antmicro/programmable-led-panel/doc/led-panel-schematic.pdf

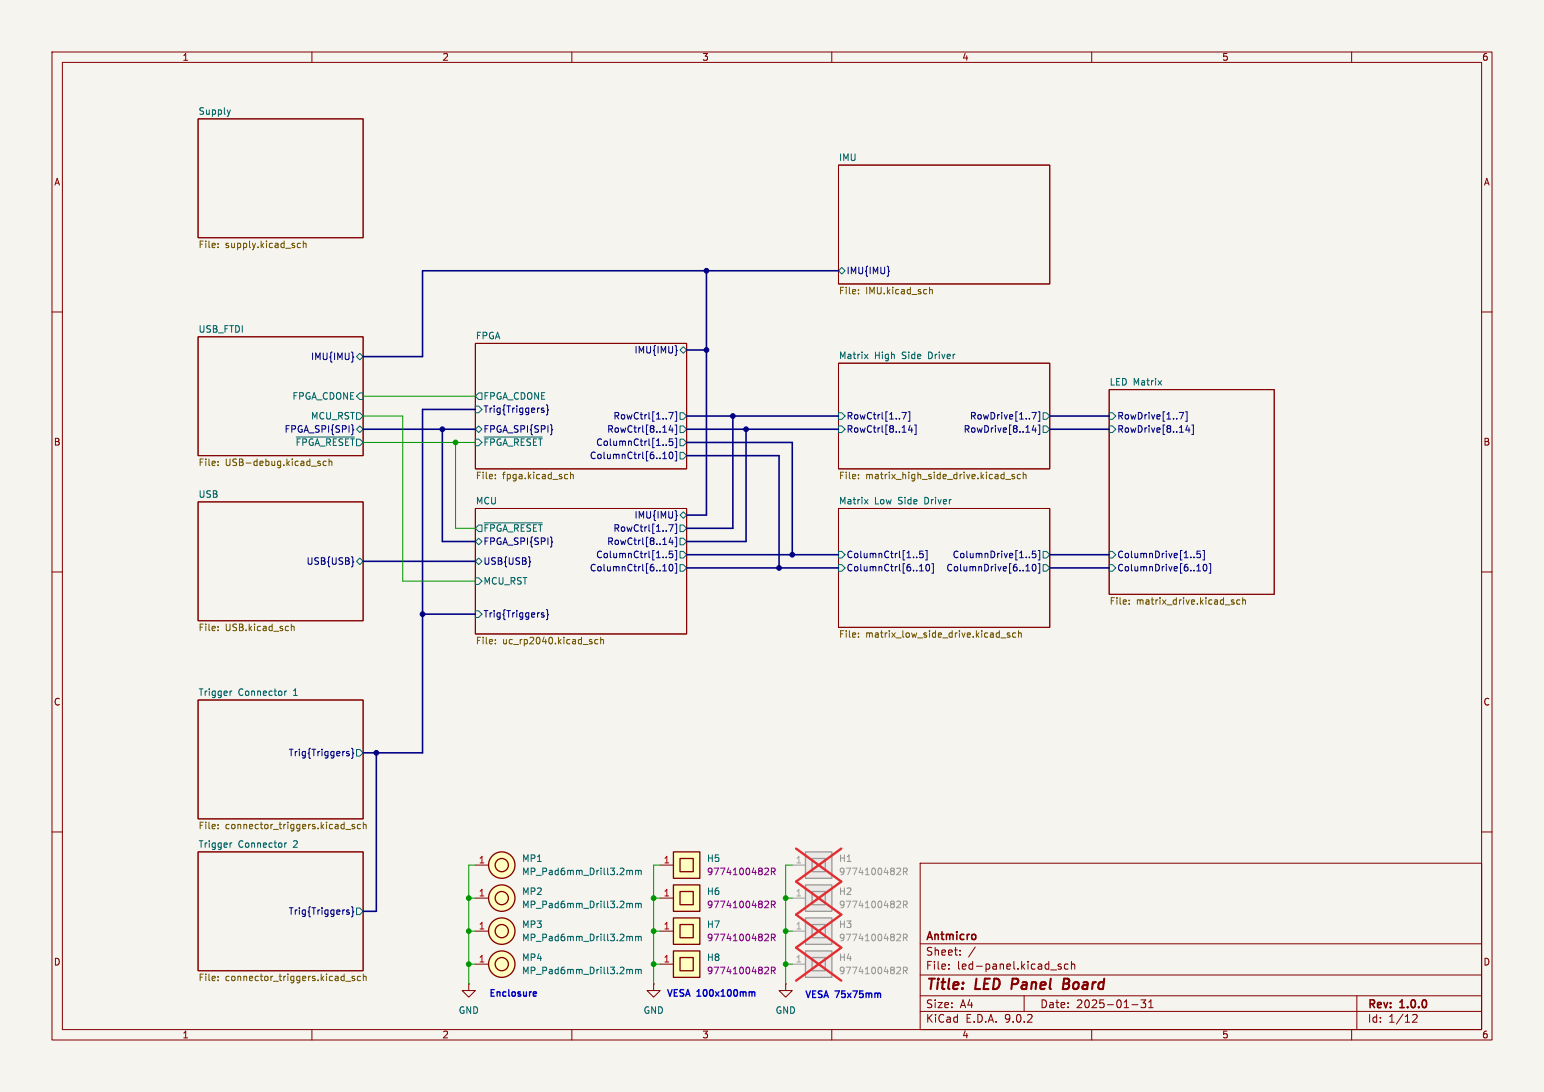
[picture p1: page 1]

RowCtrl[1..7] Matrix High Side Driver File: matrix_high_side_drive.kicad_sch

File: led-panel.kicad_sch Sheet: / Antmicro USB{USB} USB

Id: 1/12 Title: LED Panel Board

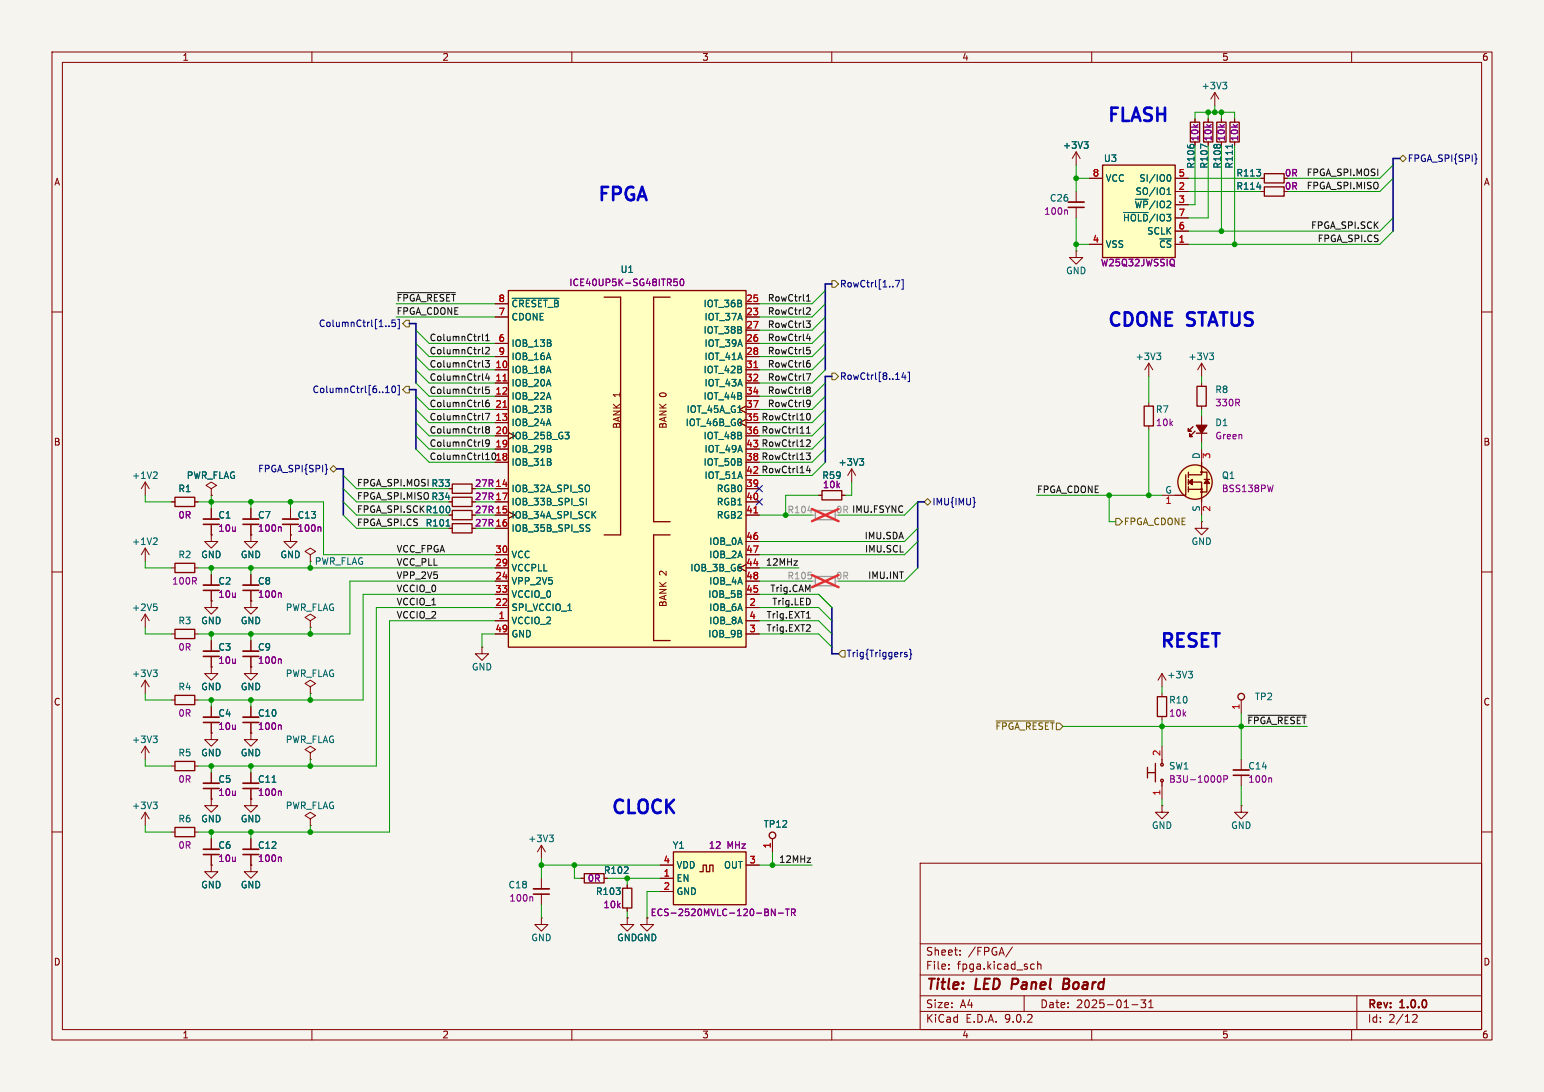
[picture p2: page 2]

File: fpga.kicad_sch Sheet: /FPGA/
Id: 2/12 Title: LED Panel Board

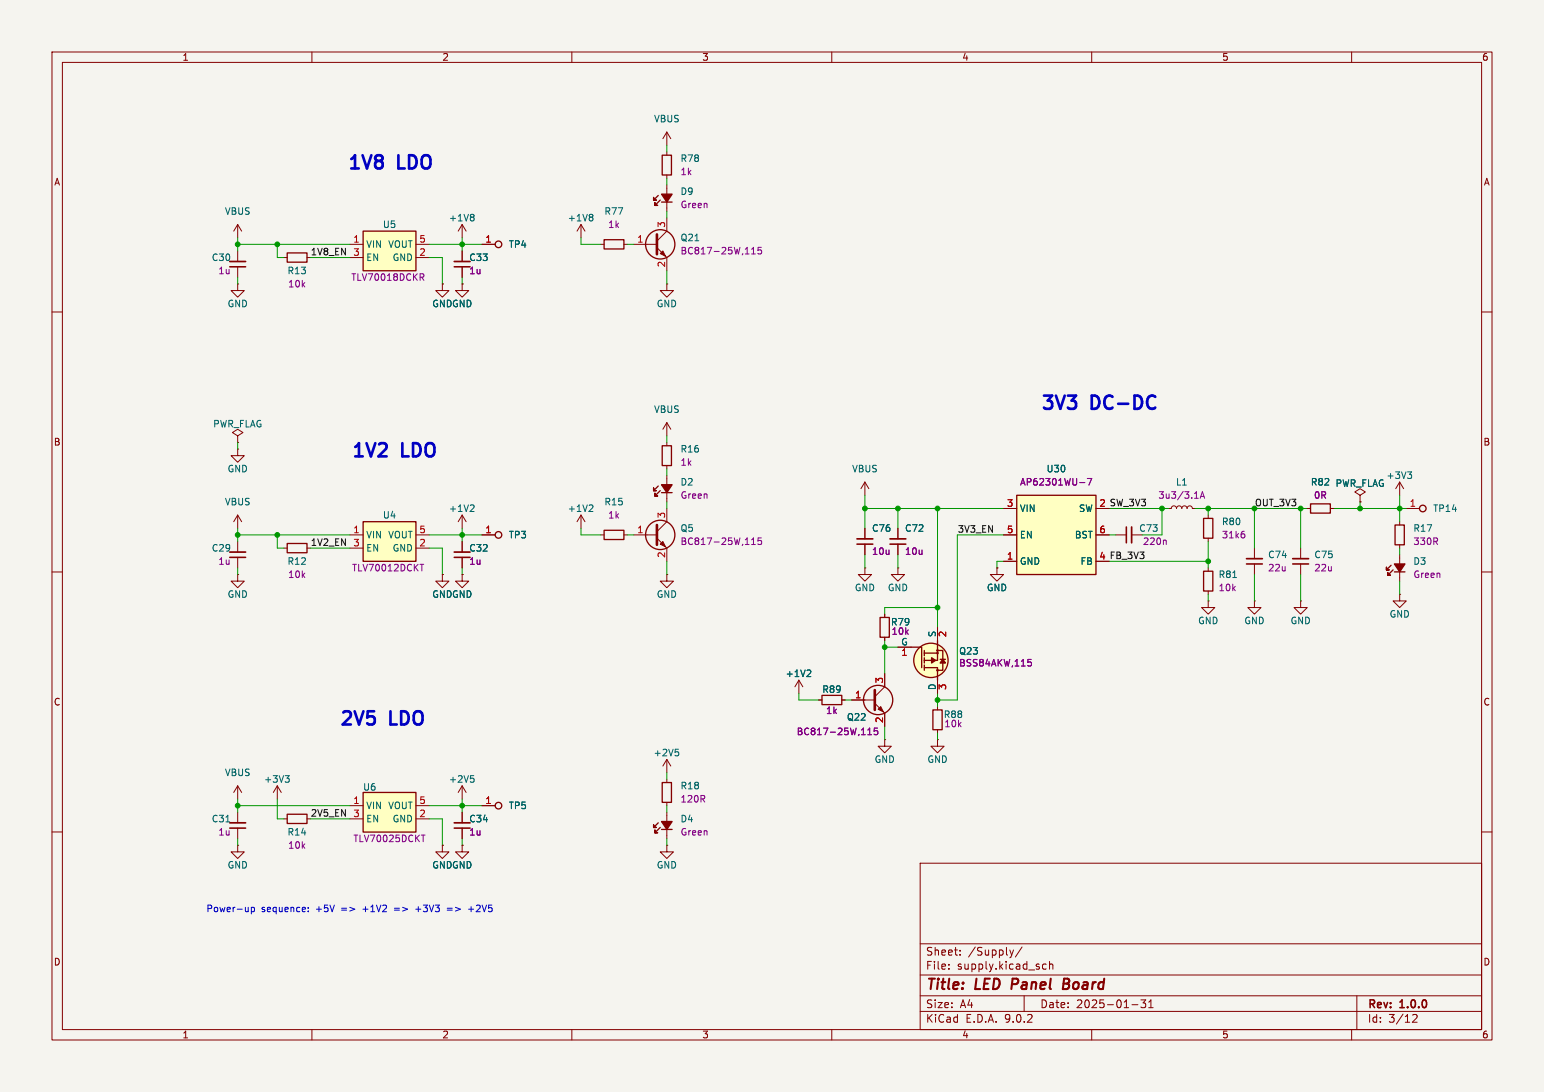
[picture p3: page 3]

File: supply.kicad_sch Sheet: /Supply/
Id: 3/12 Title: LED Panel Board

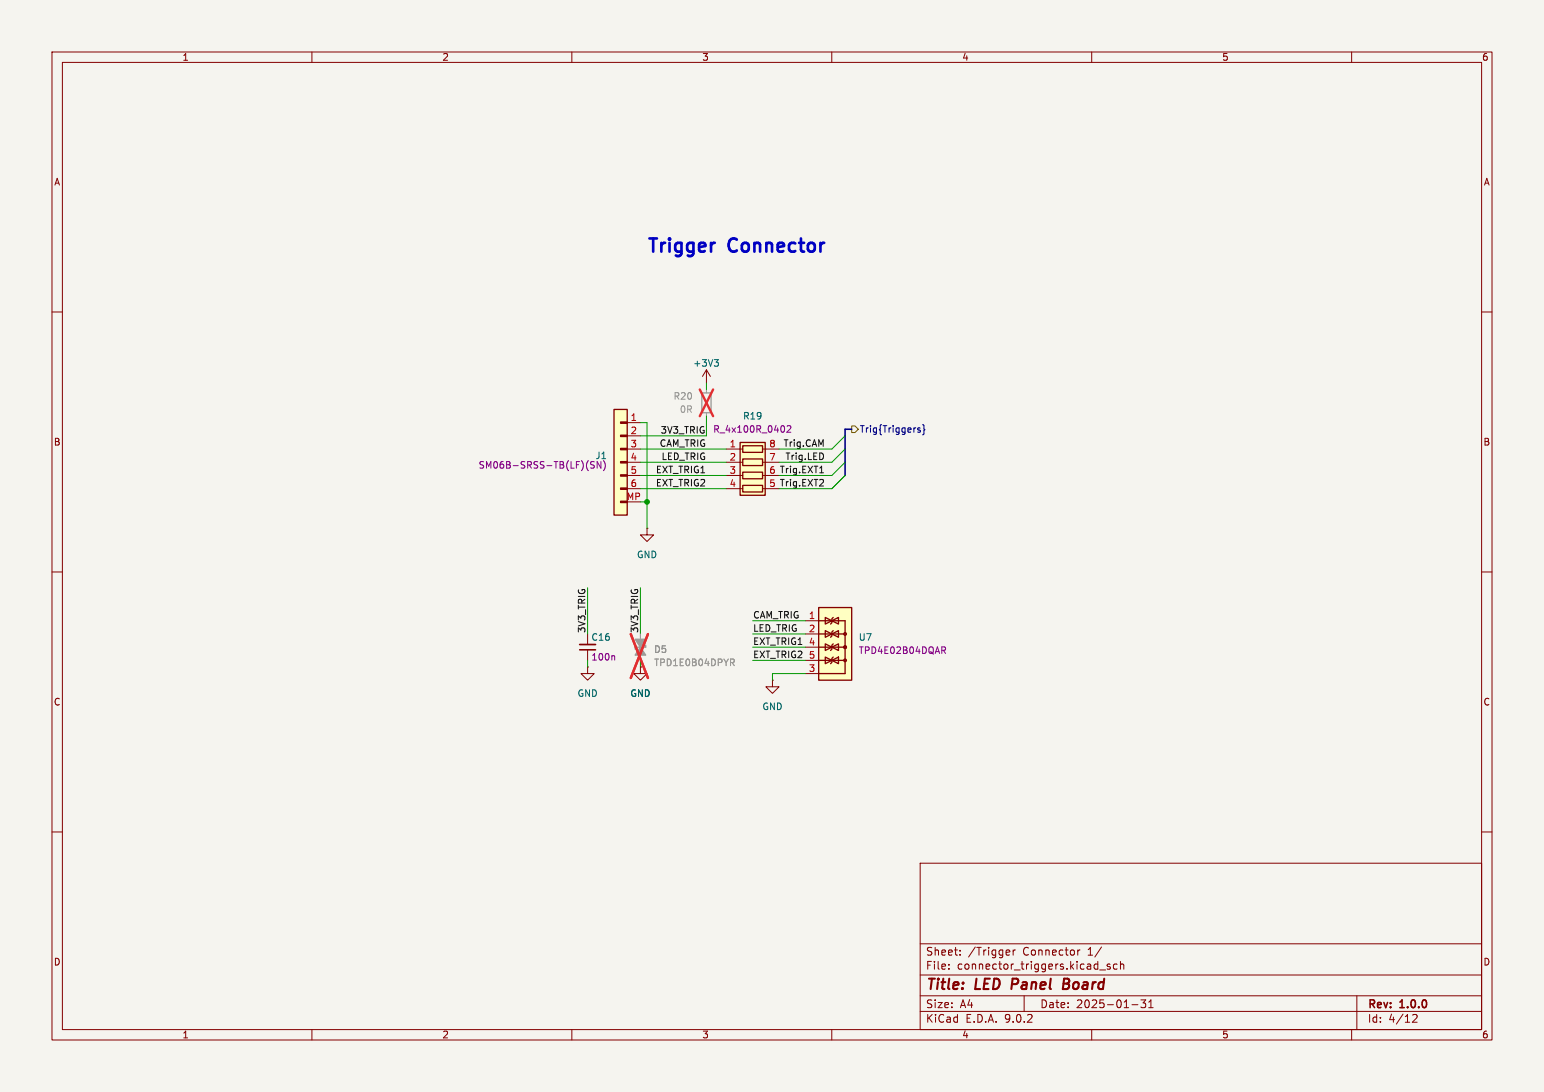
[picture p4: page 4]

4 | LED_TRIG 2 | 7 Trig.LED
5 | 3 | Trig.EXT1 6
6MP | 4

Id: 4/12 Title: LED Panel Board

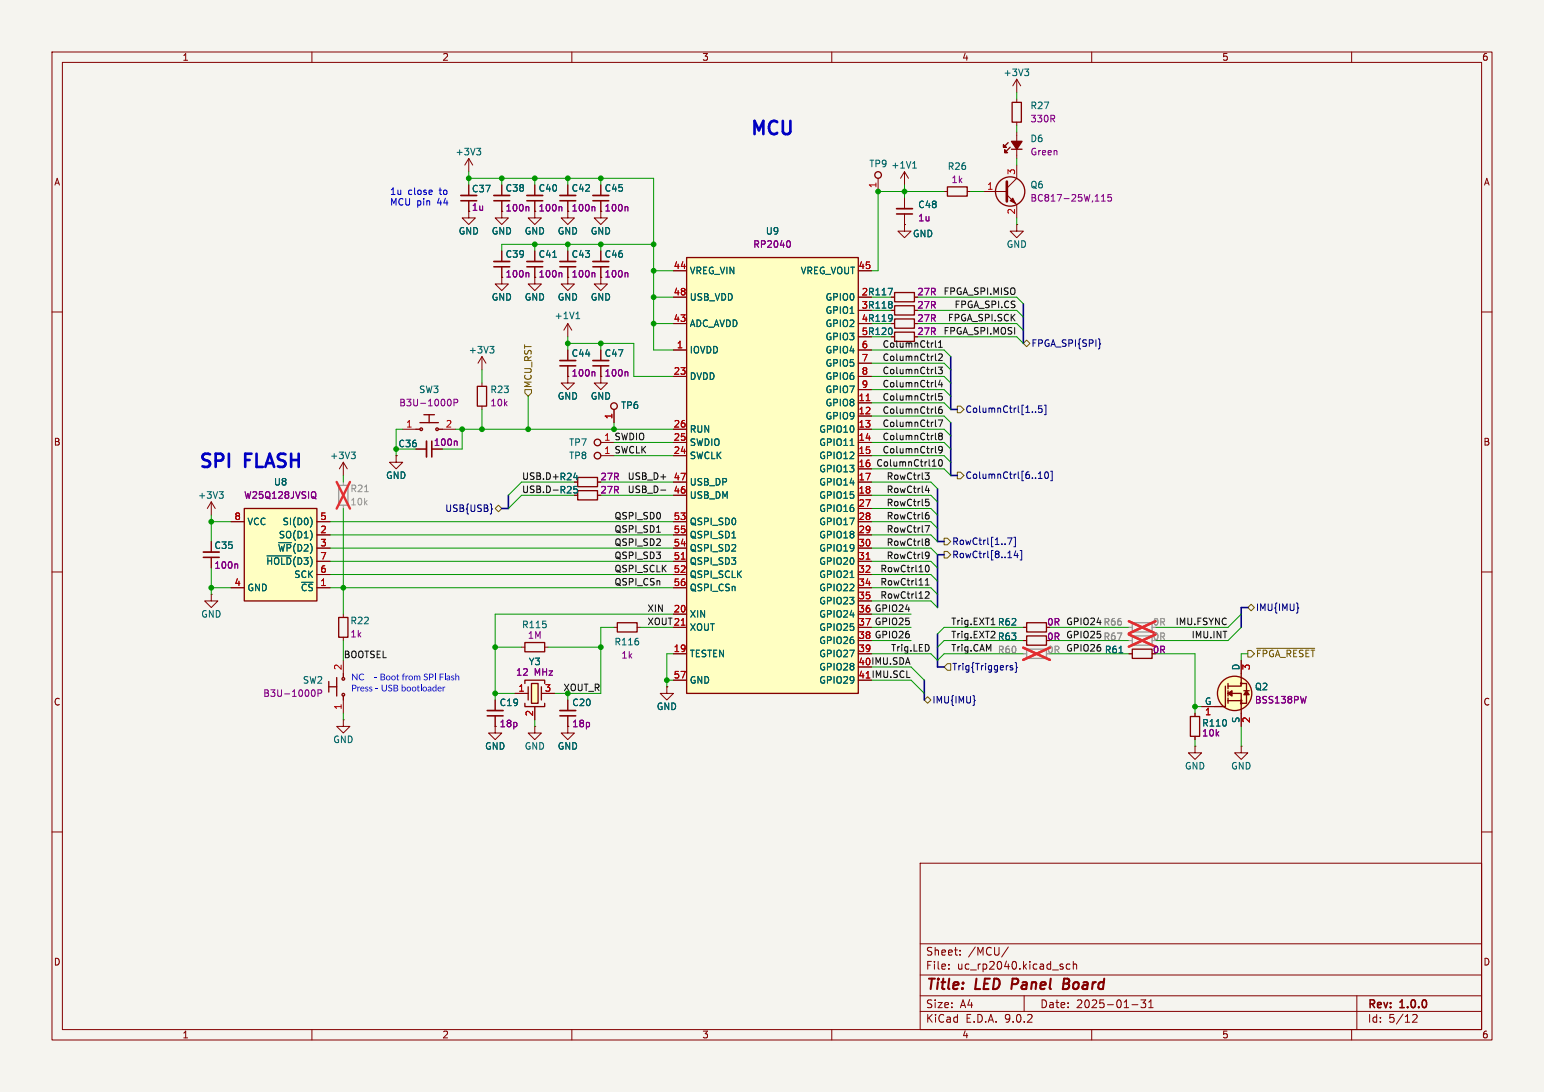
[picture p5: page 5]

IMU{IMU} USB_D- USB_D+ QSPI_SD2 QSPI_SD1 SWCLK QSPI_CSn SWDIO

SI(D0) 5 SO(D1) 2 ~{WP}(D2)3 ~{HOLD}(D3)7 SCK 6 ~{CS}1 VCC 8 GND 4 C35

File: uc_rp2040.kicad_sch Sheet: /MCU/
Id: 5/12 Title: LED Panel Board

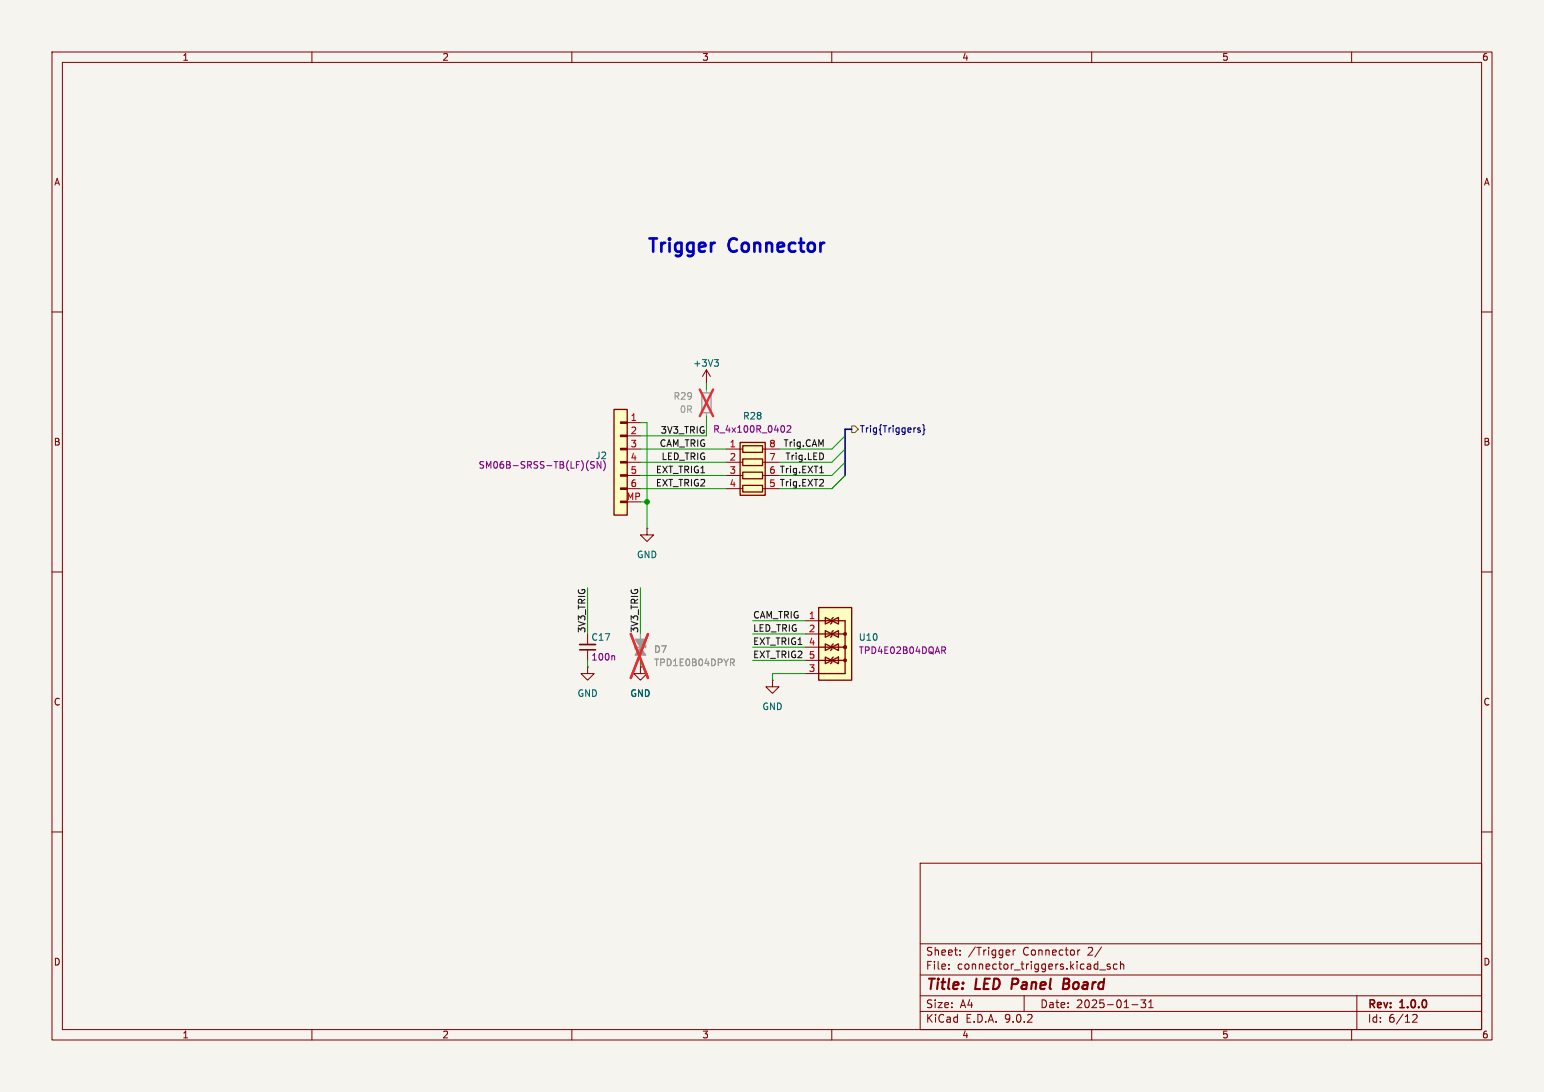
[picture p6: page 6]

4 | LED_TRIG 2 | 7 Trig.LED
5 | 3 | Trig.EXT1 6
6MP | 4

Id: 6/12 Title: LED Panel Board

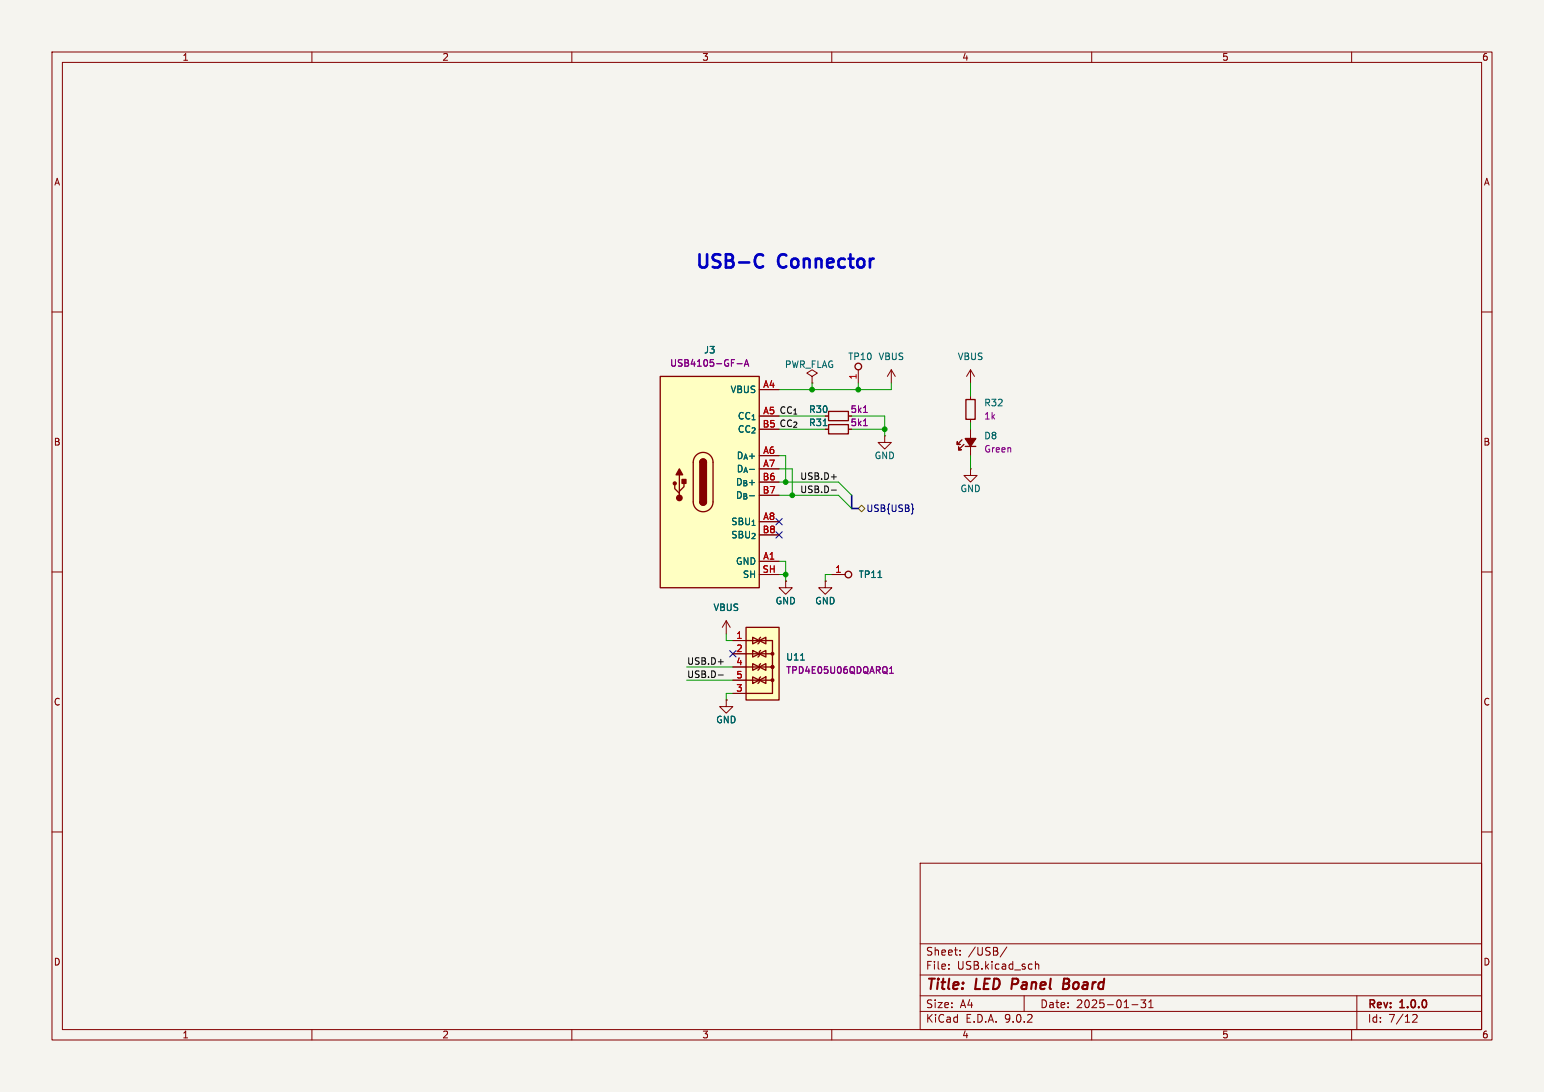
[picture p7: page 7]

File: USB.kicad_sch Sheet: /USB/
Id: 7/12 Title: LED Panel Board

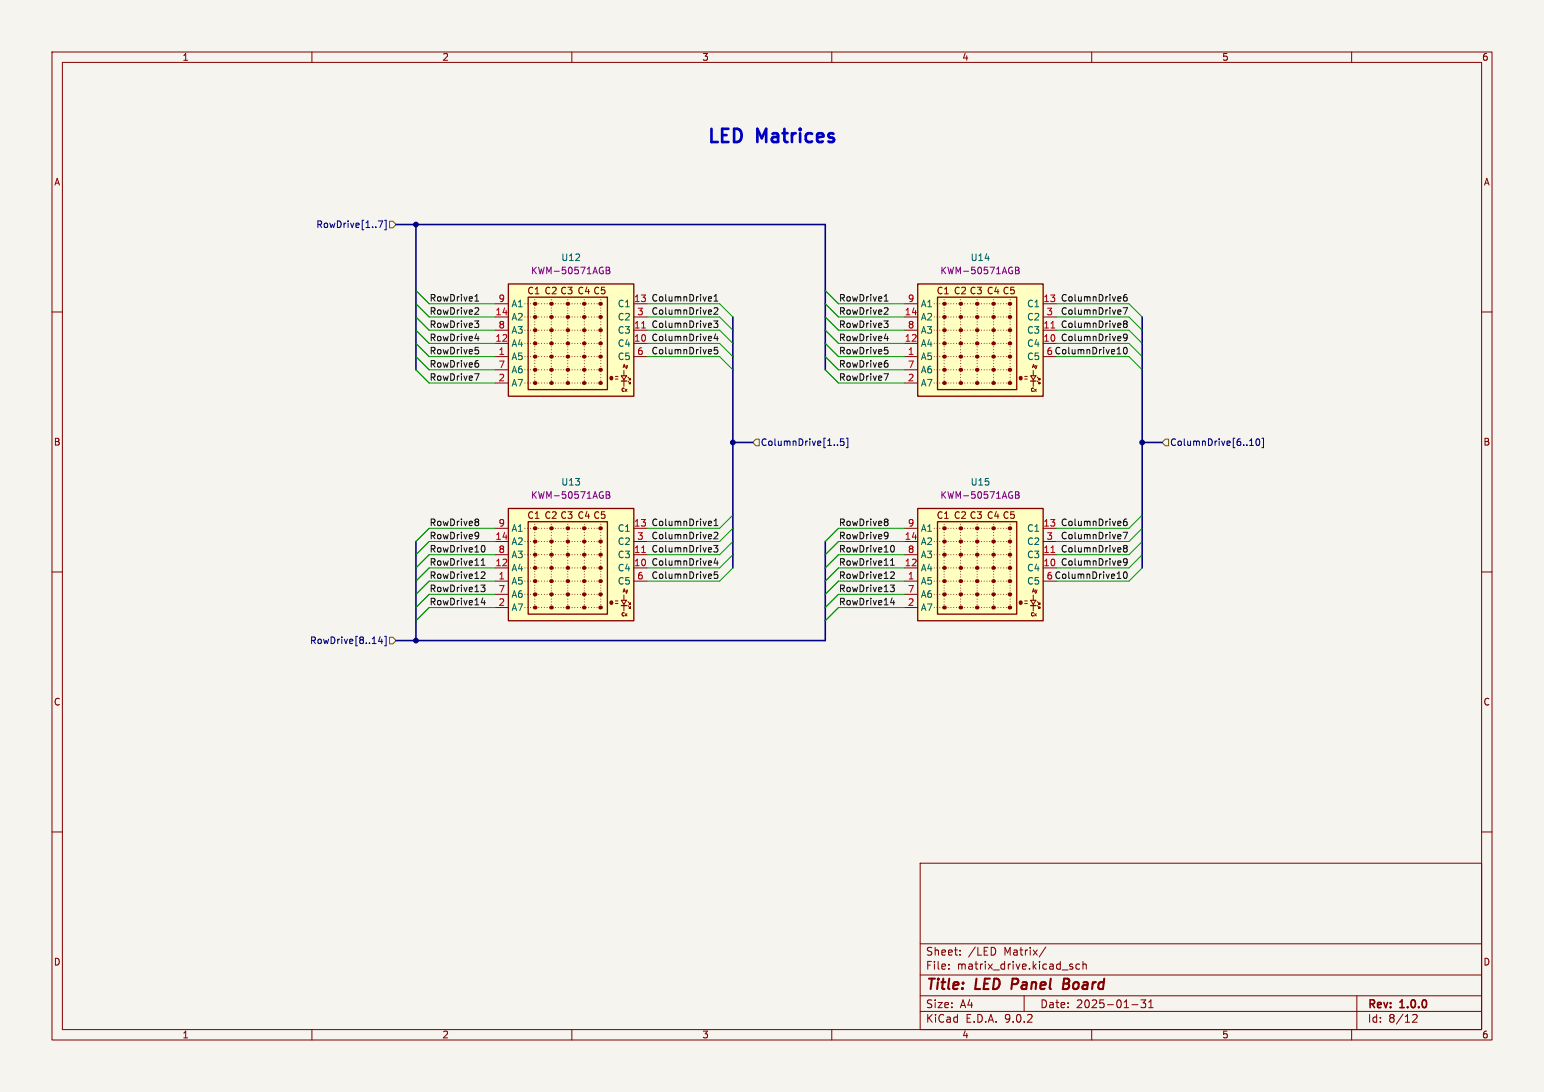
[picture p8: page 8]

Id: 8/12 Title: LED Panel Board

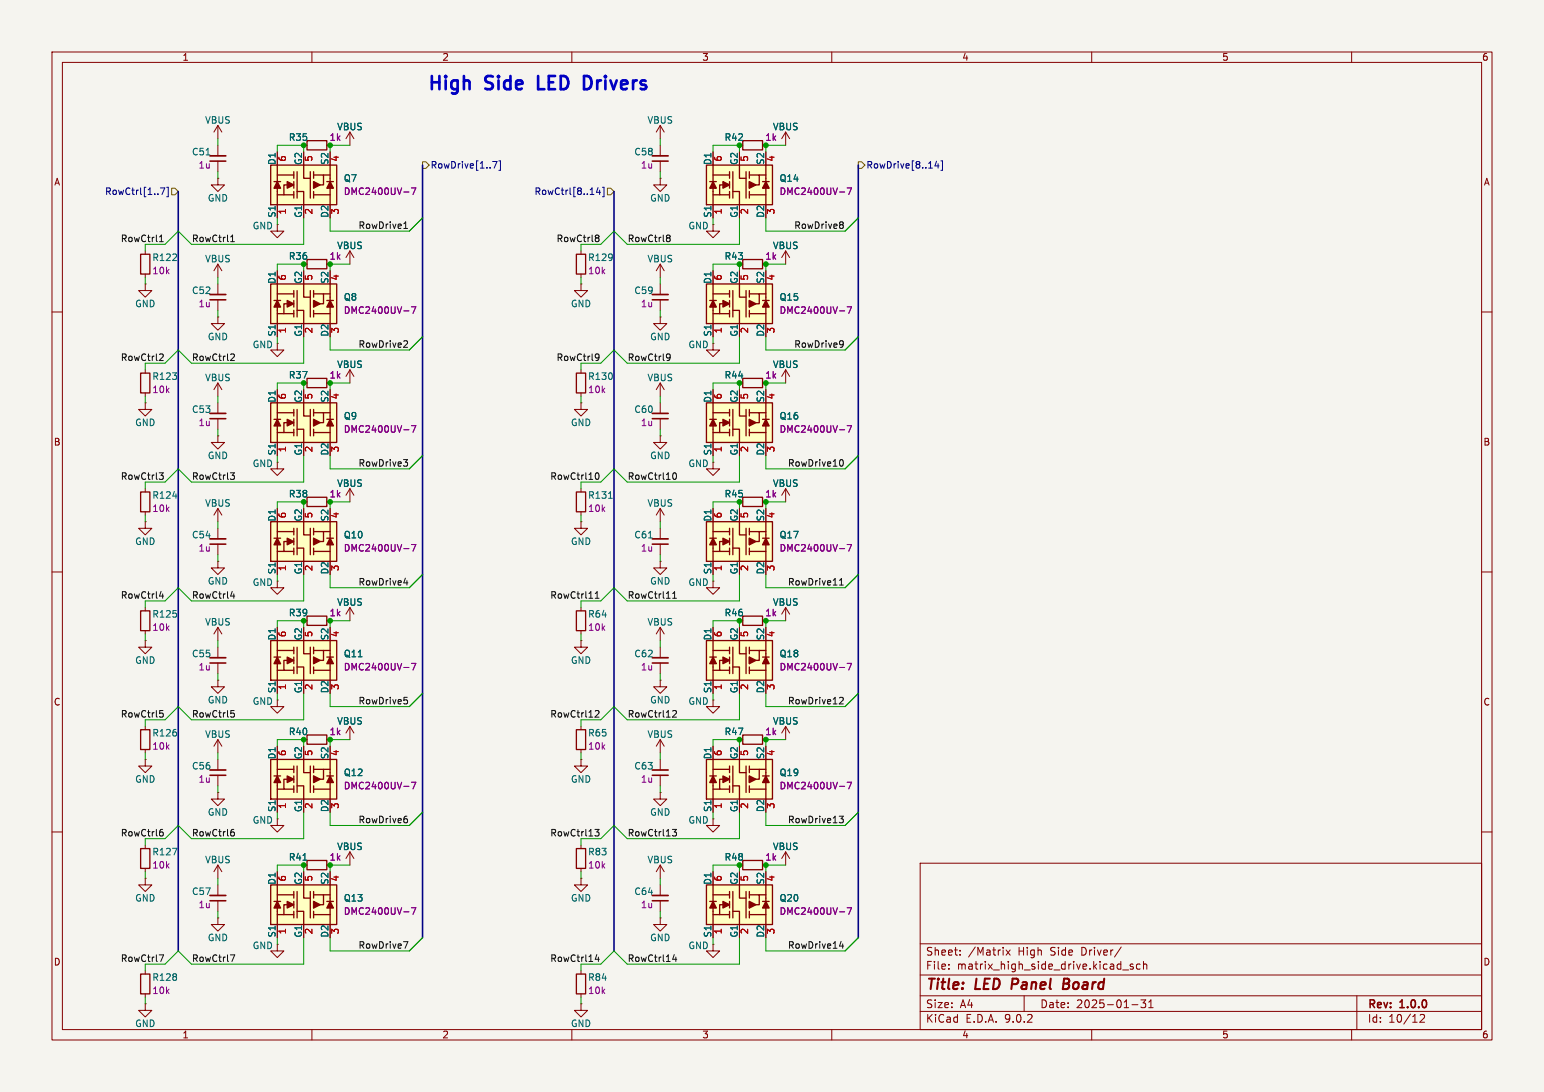
[picture p9: page 9]

Id: 10/12 Title: LED Panel Board

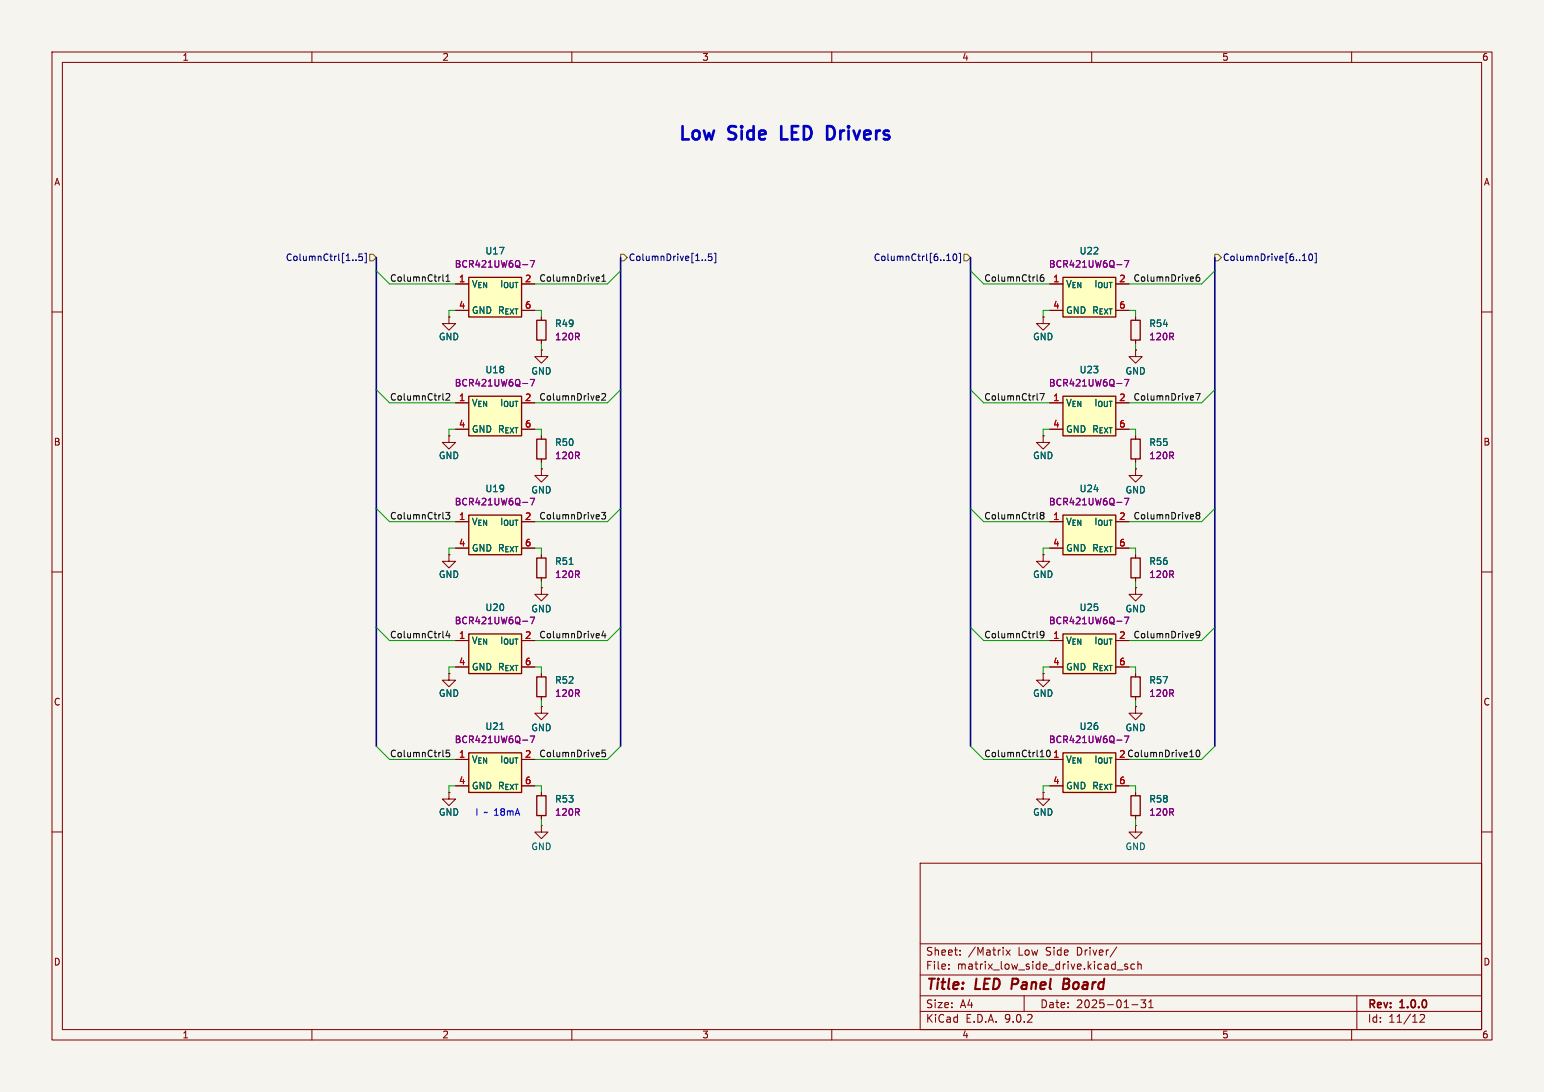
[picture p10: page 10]

Id: 11/12 Title: LED Panel Board

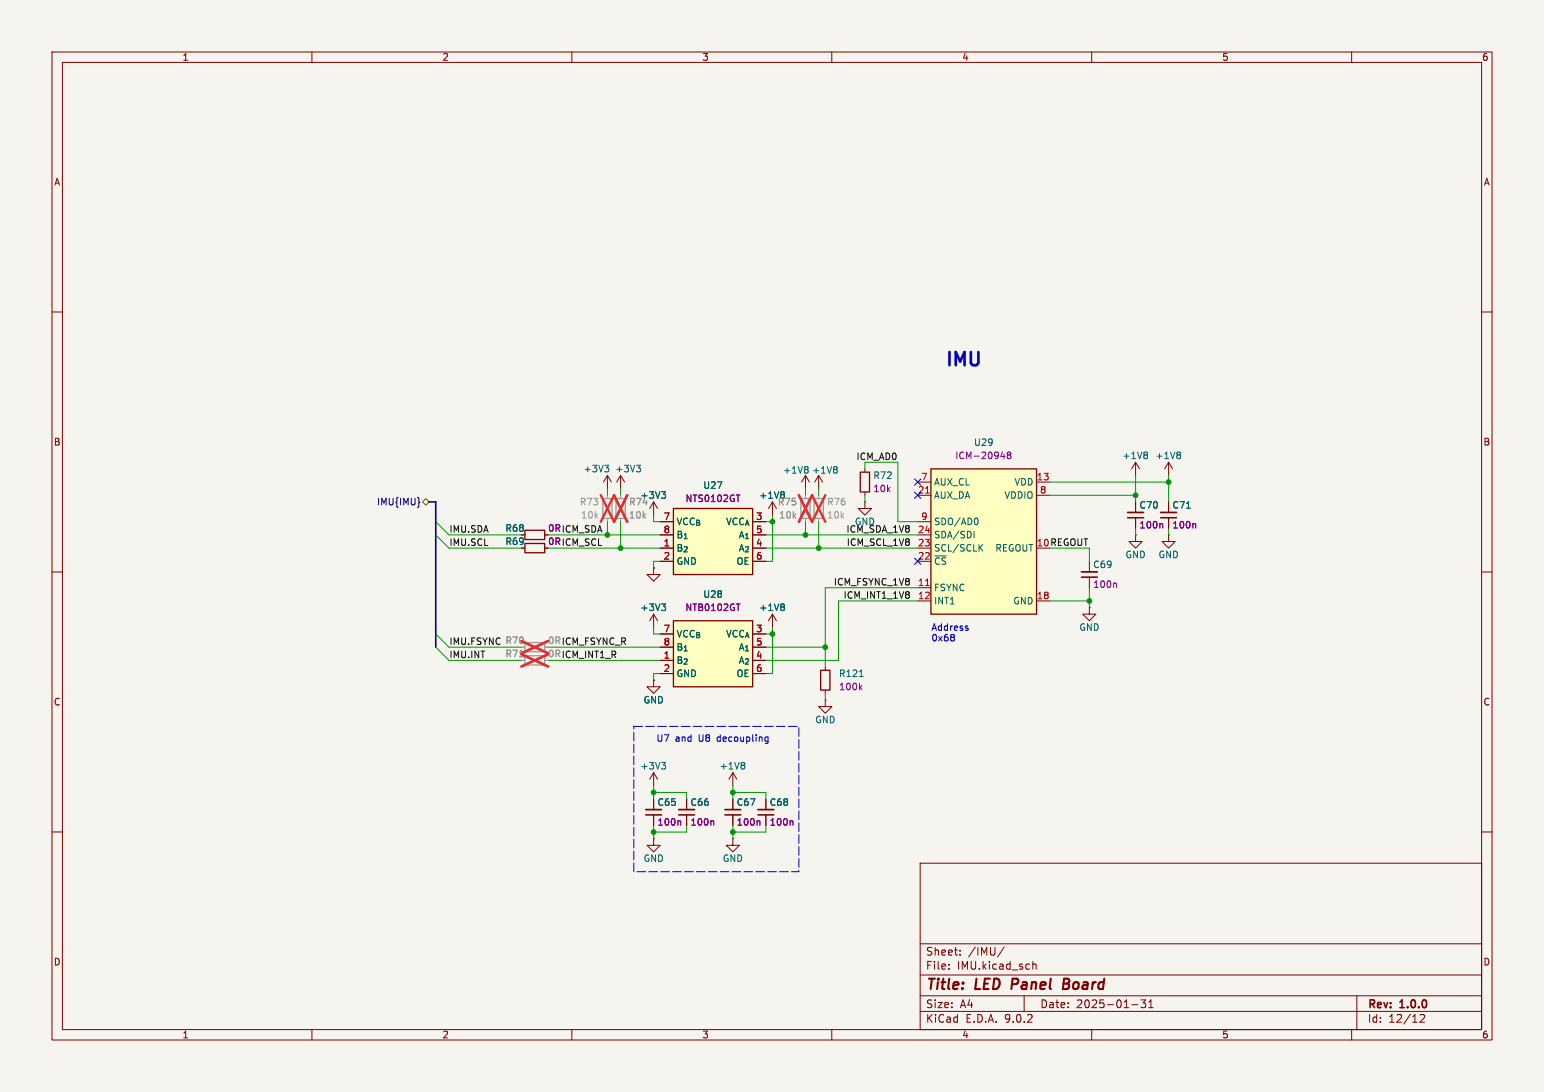
[picture p11: page 11]

File: IMU.kicad_sch Sheet: /IMU/ C66

Id: 12/12 Title: LED Panel Board

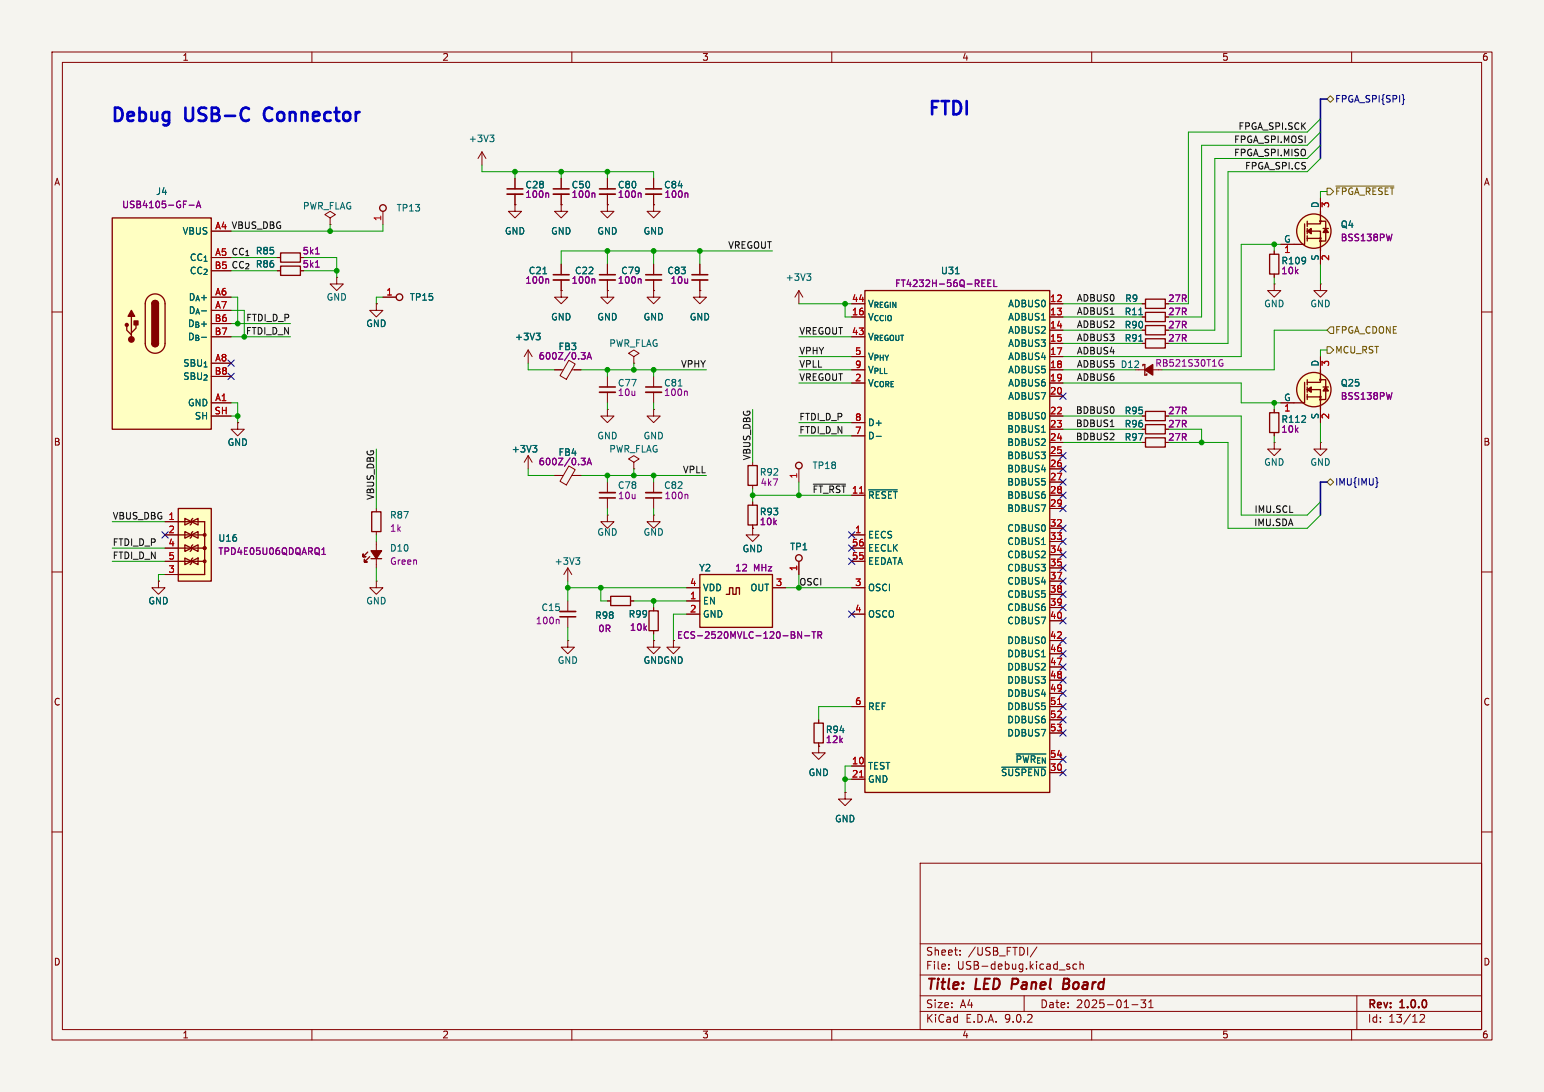
[picture p12: page 12]

U31 FT4232H-56Q-REEL V_{REGIN} 44 V_{CCIO} 16 V_{REGOUT} 43 V_{PHY} 5 V_{PLL} 9 V_{CORE} 2 D+ 8 D- 7 ~{RESET} 11 EECS 1 EECLK 56 EEDATA 55 OSCI 3 OSCO 4 REF 6 TEST 10 GND 21

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

ADBUS0 12 ADBUS1 13 ADBUS2 14 ADBUS3 15 ADBUS4 17 ADBUS5 18 ADBUS6 19 ADBUS7 20 BDBUS0 22 BDBUS1 23 BDBUS2 24 BDBUS3 25 BDBUS4 26 BDBUS5 27 BDBUS6 28 BDBUS7 29 CDBUS0 32 CDBUS1 33 CDBUS2 34 CDBUS3 35 CDBUS4 37 CDBUS5 38 CDBUS6 39 CDBUS7 40 DDBUS0 42 DDBUS1 46 DDBUS2 47 DDBUS3 48 DDBUS4 49 DDBUS5 51 DDBUS6 52 DDBUS7 53 ~{PWR_{EN}} 54 ~{SUSPEND}30 Y2 ECS-2520MVLC-120-BN-TR
GND

File: USB-debug.kicad_sch Sheet: /USB_FTDI/
Id: 13/12 Title: LED Panel Board
