antmicro/programmable-led-panel/IMU.kicad_sch

## KiCad design IMU.kicad_sch (2025-08-06, an earlier design)

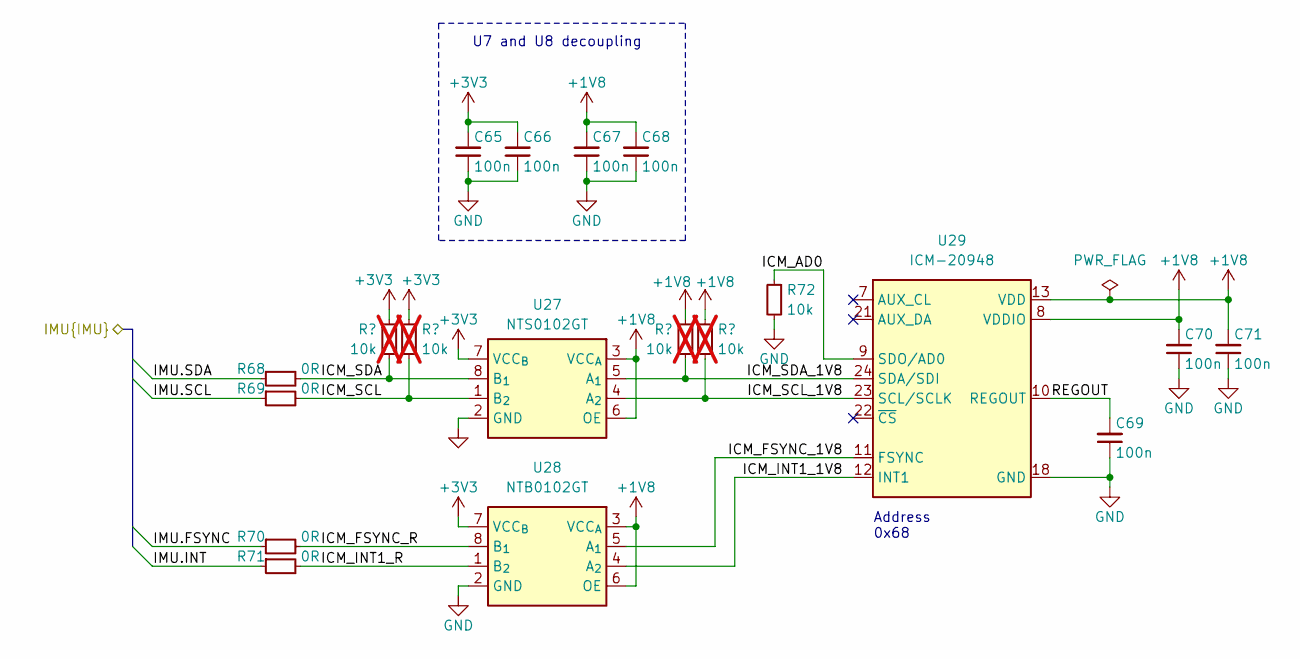
[picture p13: schematic IMU.kicad_sch]

Parts:
C65, C66, C67, C68, C69, C70, C71: C_100n_0402; C_0402_1005Metric; Voltage 50V; MPN GRM155R61H104KE14D
R68, R69, R70, R71: R_0R_0402; R_0402_1005Metric; MPN ERJ2GE0R00X
R72: R_10k_0402; R_0402_1005Metric; Tolerance 1%; MPN CR0402-FX-1002GLF
U27: NTS0102_XSON; XSON-8_1x1.95mm_P0.5mm; MPN NTS0102GT
U28: NTB0102_XSON; XSON-8_1x1.95mm_P0.5mm; MPN NTB0102GT
U29: ICM-20948; InvenSense_QFN-24_3x3mm_P0.4mm; MPN ICM-20948

Connections:
+1V8: C67.2, C68.2, C70.2, C71.2, U27.3 (VCC_{A}), U27.6 (OE), U28.3 (VCC_{A}), U28.6 (OE), U29.8 (VDDIO), U29.13 (VDD)
+3V3: C65.2, C66.2, U27.7 (VCC_{B}), U28.7 (VCC_{B})
GND: C65.1, C66.1, C67.1, C68.1, C69.1, C70.1, C71.1, R72.2, U27.2 (GND), U28.2 (GND), U29.18 (GND), U29.20 (GND)
ICM_AD0: R72.1, U29.9 (SDO/AD0)
ICM_FSYNC_1V8: U28.5 (A_{1}), U29.11 (FSYNC)
ICM_FSYNC_R: R70.2, U28.8 (B_{1})
ICM_INT1_1V8: U28.4 (A_{2}), U29.12 (INT1)
ICM_INT1_R: R71.2, U28.1 (B_{2})
ICM_SCL: R69.2, U27.1 (B_{2})
ICM_SCL_1V8: U27.4 (A_{2}), U29.23 (SCL/SCLK)
ICM_SDA: R68.2, U27.8 (B_{1})
ICM_SDA_1V8: U27.5 (A_{1}), U29.24 (SDA/SDI)
IMU.FSYNC: R70.1
IMU.INT: R71.1
IMU.SCL: R69.1
IMU.SDA: R68.1
REGOUT: C69.2, U29.10 (REGOUT)

Notes on the sheet:
U7 and U8 decoupling
Address 0x68
