antmicro/programmable-led-panel/USB-debug.kicad_sch

## KiCad design USB-debug.kicad_sch (2025-08-06, an earlier design)

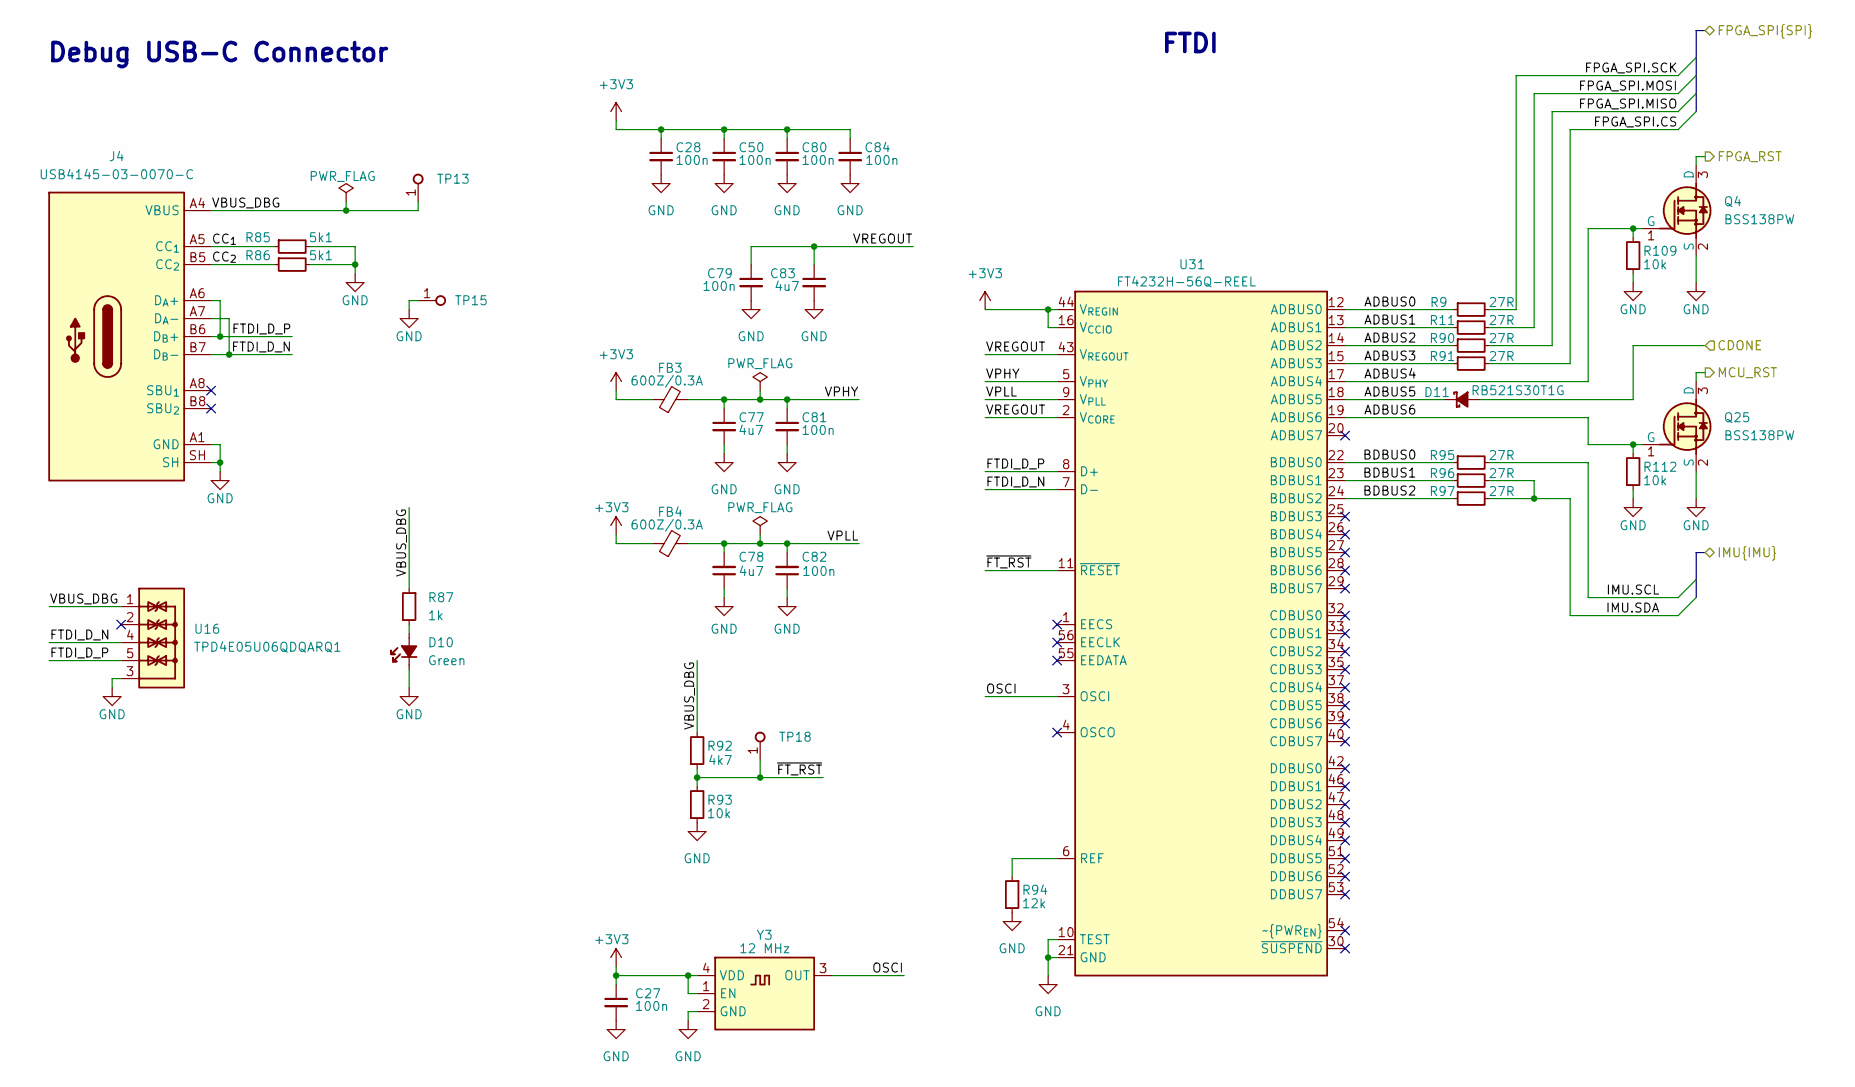
[picture p14: schematic USB-debug.kicad_sch]

Parts:
C27, C28, C50, C79, C80, C81, C82, C84: C_100n_16V_X7R_0402; C_0402_1005Metric; Voltage 16V; MPN C0402C104J4RAC7411
C77, C78, C83: C_4u7_0402; C_0402_1005Metric; MPN GRM155R61A475MEAAD
D10: LED_G_0603_KP-1608CGCK; LED_0603_1608Metric_G; MPN KP-1608CGCK
D11: RB521S30T1G; SOD-523; MPN RB521S30T1G
FB3, FB4: FB_600Z_0.3A_Murata-BLM15AG_0402; FB_0402_1005Metric; MPN BLM15AG601SN1D
J4: USB-C_GCT_USB4145-03-0070-C; USB-C_Receptacle_GCT_USB4145-03-0070-C; MPN USB4145-03-0070-C
Q4, Q25: BSS138PW; SC70-3; MPN BSS138PW
R9, R11, R90, R91, R95, R96, R97: R_27R_0402; R_0402_1005Metric; Tolerance 1%; MPN CR0402-FX-27R0GLF
R85, R86: R_5k1_0402; R_0402_1005Metric; Tolerance 1%; MPN CR0402-FX-5101GLF
R87: R_1k_0402; R_0402_1005Metric; Tolerance 1%; MPN CR0402-FX-1001GLF
R92: R_4k7_0402; R_0402_1005Metric; Tolerance 1%; MPN CR0402-FX-4701GLF
R93, R109, R112: R_10k_0402; R_0402_1005Metric; Tolerance 1%; MPN CR0402-FX-1002GLF
R94: R_12k_0402; R_0402_1005Metric; Tolerance 1%; MPN CR0402-FX-1202GLF
TP13, TP15, TP18: TP_0.75mm_SMD; TP_SMD_0.75mm
U16: TPD4E05U06QDQARQ1; USON-10_2.5x1mm_P0.5mm; MPN TPD4E05U06QDQARQ1
U31: FT4232H_VQFN; QFN-56-1EP_8x8mm_P0.5mm; MPN FT4232H-56Q-REEL
Y3: Oscillator_12MHz_ASFLMB; Oscillator_SMD_Abracon_ASFLMB_5x3.2x0.85mm; MPN ASFLMB-12.000MHZ-LC-T

Connections:
+3V3: C27.1, C28.1, C50.1, C80.1, C84.1, FB3.1, FB4.1, U31.16 (V_{CCIO}), U31.36 (V_{CCIO}), U31.44 (V_{REGIN}), U31.50 (V_{CCIO}), Y3.1 (EN), Y3.4 (VDD)
ADBUS0: R9.1, U31.12 (ADBUS0)
ADBUS1: R11.1, U31.13 (ADBUS1)
ADBUS2: R90.1, U31.14 (ADBUS2)
ADBUS3: R91.1, U31.15 (ADBUS3)
ADBUS4: Q4.1 (G), R109.2, U31.17 (ADBUS4)
ADBUS5: D11.1 (C), U31.18 (ADBUS5)
ADBUS6: Q25.1 (G), R112.2, U31.19 (ADBUS6)
BDBUS0: R95.1, U31.22 (BDBUS0)
BDBUS1: R96.1, U31.23 (BDBUS1)
BDBUS2: R97.1, U31.24 (BDBUS2)
CC_{1}: J4.A5 (CC_{1}), R85.1
CC_{2}: J4.B5 (CC_{2}), R86.1
CDONE: D11.2 (A)
FPGA_RST: Q4.3 (D)
FPGA_SPI.CS: R91.2
FPGA_SPI.MISO: R90.2
FPGA_SPI.MOSI: R11.2
FPGA_SPI.SCK: R9.2
FTDI_D_N: J4.A7 (D_{A}-), J4.B7 (D_{B}-), U16.4, U16.7, U31.7 (D-)
FTDI_D_P: J4.A6 (D_{A}+), J4.B6 (D_{B}+), U16.5, U16.6, U31.8 (D+)
GND: C27.2, C28.2, C50.2, C77.2, C78.1, C79.2, C80.2, C81.2, C82.1, C83.2, C84.2, D10.1 (C), J4.A1 (GND), J4.A12 (GND), J4.B1 (GND), J4.B12 (GND), J4.SH, Q4.2 (S), Q25.2 (S), R85.2, R86.2, R93.1, R94.2, R109.1, R112.1, TP15.1, U16.3, U16.8, U31.10 (TEST), U31.21 (GND), U31.41 (GND), U31.45 (GND), U31.57 (GND), Y3.2 (GND)
IMU.SCL: R95.2
IMU.SDA: R96.2, R97.2
MCU_RST: Q25.3 (D)
unnamed: D10.2 (A), R87.2
unnamed: R94.1, U31.6 (REF)
unnamed: U16.2, U16.9
OSCI: U31.3 (OSCI), Y3.3 (OUT)
VBUS_DBG: J4.A4 (VBUS), J4.A9 (VBUS), J4.B4 (VBUS), J4.B9 (VBUS), R87.1, R92.2, TP13.1, U16.1, U16.10
VPHY: C77.1, C81.1, FB3.2, U31.5 (V_{PHY})
VPLL: C78.2, C82.2, FB4.2, U31.9 (V_{PLL})
VREGOUT: C79.1, C83.1, U31.2 (V_{CORE}), U31.31 (V_{CORE}), U31.43 (V_{REGOUT})
~FT_RST: R92.1, R93.2, TP18.1, U31.11 (~RESET)

Notes on the sheet:
FTDI
Debug USB-C Connector
