antmicro/programmable-led-panel/fpga.kicad_sch

## KiCad design fpga.kicad_sch (2025-08-06, an earlier design)

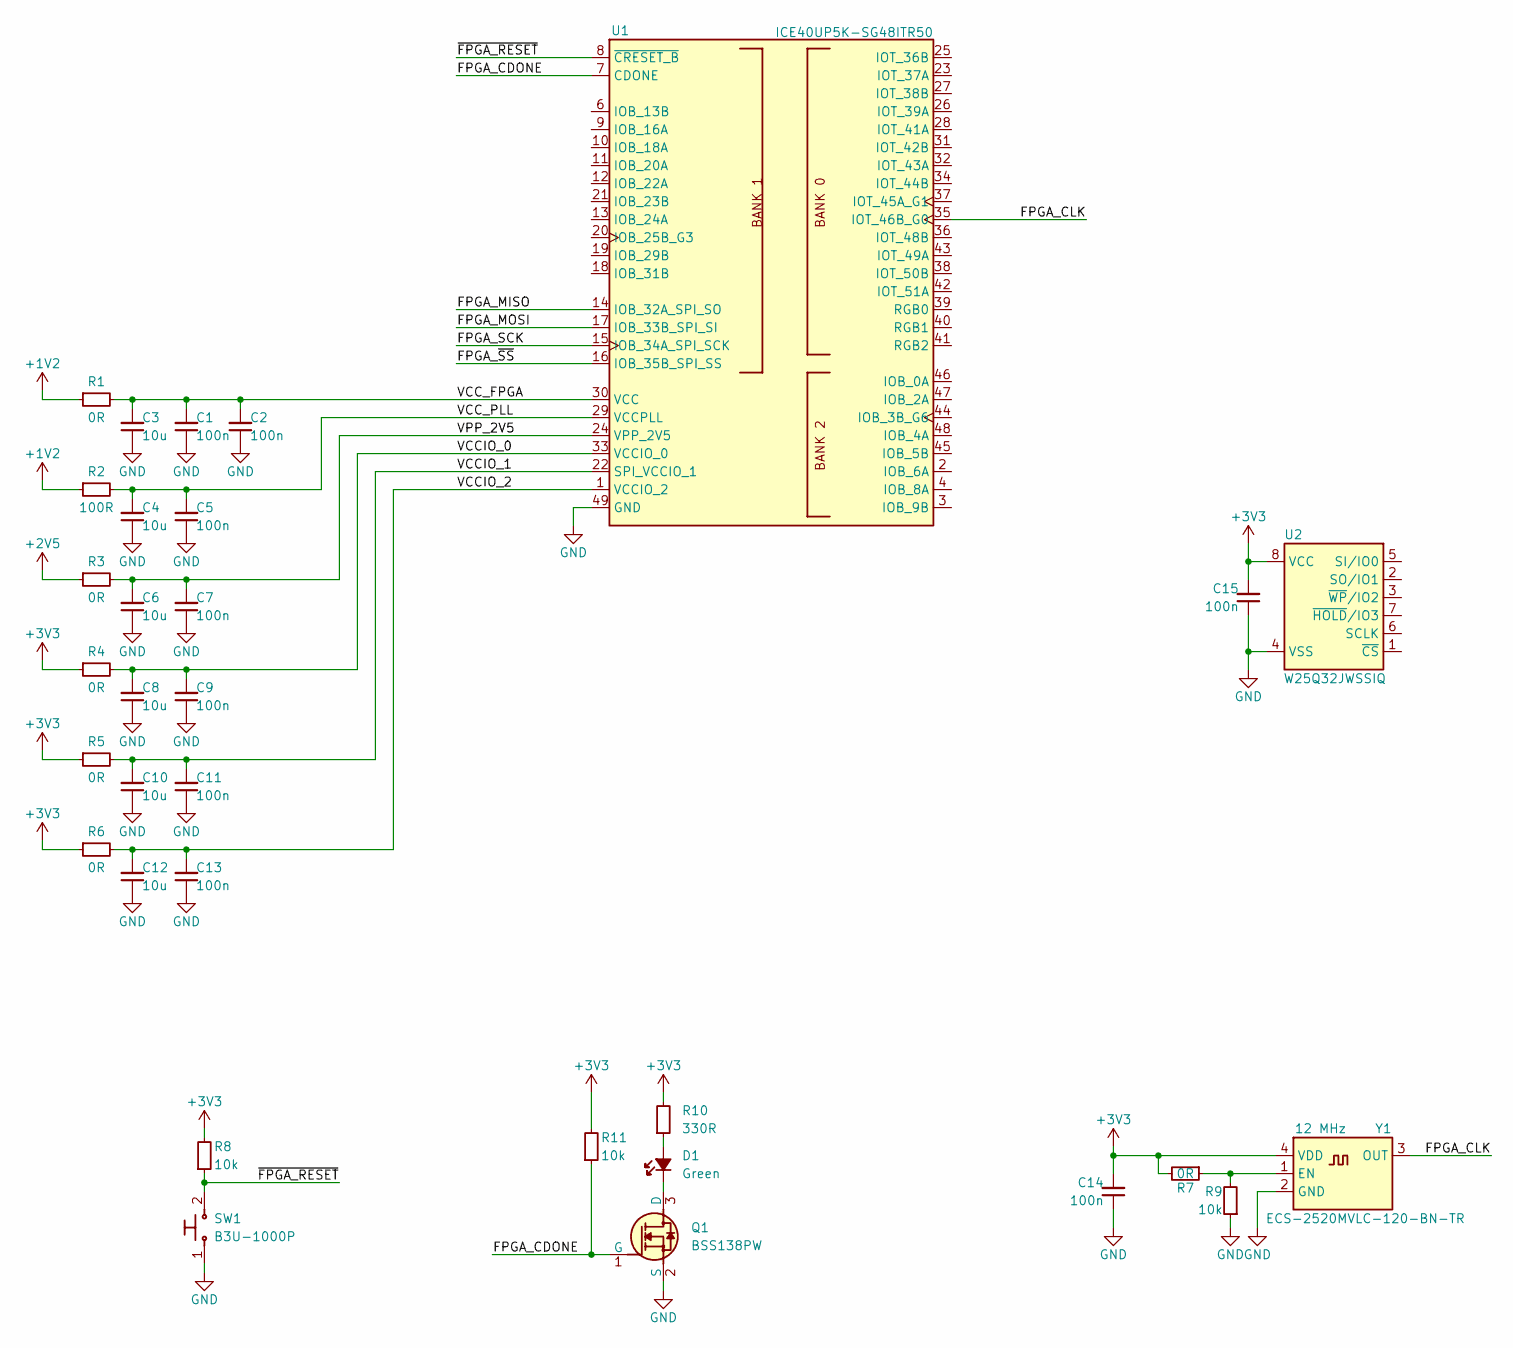
[picture p15: schematic fpga.kicad_sch]

Parts:
C1, C2, C5, C7, C9, C11, C13, C14, C15: C_100n_0402; C_0402_1005Metric; Voltage 50V; MPN GRM155R61H104KE14D
C3, C4, C6, C8, C10, C12: C_10u_10V_0402; C_0402_1005Metric; Voltage 10V; MPN GRM155R61A106ME11D
D1: LED_G_0603_KP-1608CGCK; LED_0603_1608Metric_G; MPN KP-1608CGCK
Q1: BSS138PW; SC70-3; MPN BSS138PW
R1, R3, R4, R5, R6, R7: R_0R_0402; R_0402_1005Metric; MPN ERJ2GE0R00X
R2: R_100R_0402; R_0402_1005Metric; Tolerance 1%; MPN CR0402-FX-1000GLF
R8, R9, R11: R_10k_0402; R_0402_1005Metric; Tolerance 1%; MPN CR0402-FX-1002GLF
R10: R_330R_0402; R_0402_1005Metric; Tolerance 1%; MPN CR0402-FX-3300GLF
SW1: SW_B3U-1000P_SMD; MPN B3U-1000P
U1: ICE40UP5K-SG48; QFN-48-1EP_7x7mm; MPN ICE40UP5K-SG48ITR50
U2: W25Q32JW_SOIC-8; SOIC-8_5.3x5.3x2mm_P1.27mm; MPN W25Q32JWSSIQ
Y1: Oscillator_12MHz_ESC_2520MV; Oscillator_SMD_ECS_2520MV_2.5x2mm; MPN ECS-2520MVLC-120-BN-TR

Connections:
+1V2: R1.1, R2.1
+2V5: R3.1
+3V3: C14.2, C15.2, R4.1, R5.1, R6.1, R7.2, R8.2, R10.2, R11.2, U2.8 (VCC), Y1.4 (VDD)
FPGA_CDONE: Q1.1 (G), R11.1, U1.7 (CDONE)
FPGA_CLK: U1.35 (IOT_46B_G0), Y1.3 (OUT)
FPGA_MISO: U1.14 (IOB_32A_SPI_SO)
FPGA_MOSI: U1.17 (IOB_33B_SPI_SI)
FPGA_SCK: U1.15 (IOB_34A_SPI_SCK)
FPGA_~SS: U1.16 (IOB_35B_SPI_SS)
GND: C1.1, C2.1, C3.1, C4.1, C5.1, C6.1, C7.1, C8.1, C9.1, C10.1, C11.1, C12.1, C13.1, C14.1, C15.1, Q1.2 (S), R9.1, SW1.1, U1.49 (GND), U2.4 (VSS), Y1.2 (GND)
unnamed: D1.1 (C), Q1.3 (D)
unnamed: D1.2 (A), R10.1
unnamed: R7.1, R9.2, Y1.1 (EN)
VCCIO_0: C8.2, C9.2, R4.2, U1.33 (VCCIO_0)
VCCIO_1: C10.2, C11.2, R5.2, U1.22 (SPI_VCCIO_1)
VCCIO_2: C12.2, C13.2, R6.2, U1.1 (VCCIO_2)
VCC_FPGA: C1.2, C2.2, C3.2, R1.2, U1.5 (VCC), U1.30 (VCC)
VCC_PLL: C4.2, C5.2, R2.2, U1.29 (VCCPLL)
VPP_2V5: C6.2, C7.2, R3.2, U1.24 (VPP_2V5)
~FPGA_RESET: R8.1, SW1.2, U1.8 (~CRESET_B)
