antmicro/programmable-led-panel/supply.kicad_sch

## KiCad design supply.kicad_sch (2025-08-06, an earlier design)

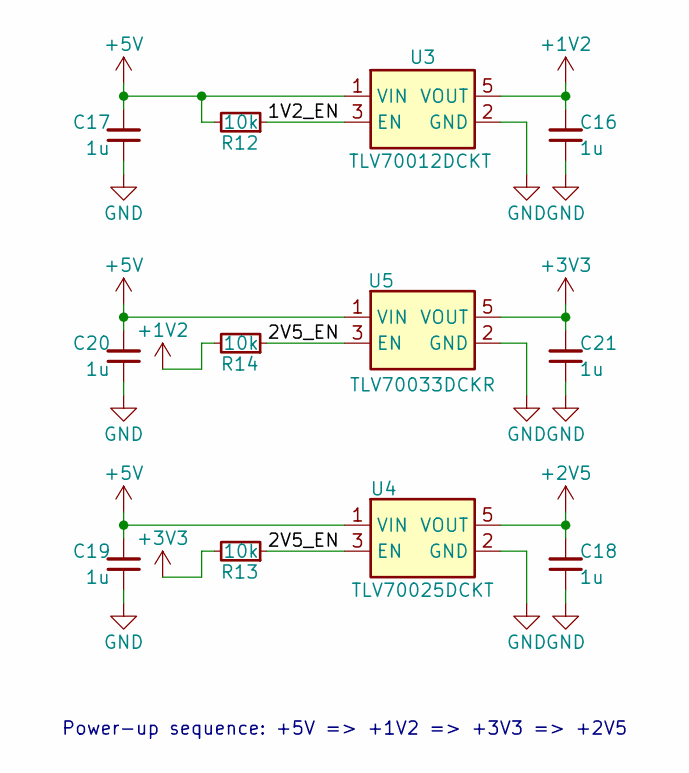
[picture p16: schematic supply.kicad_sch]

Parts:
C16, C17, C18, C19, C20, C21: C_1u_16V_0402; C_0402_1005Metric; Voltage 16V; MPN C0402C105M4PACTU
R12, R13, R14: R_10k_0402; R_0402_1005Metric; Tolerance 1%; MPN CR0402-FX-1002GLF
U3: TLV70012_SC70; SC-70-5; MPN TLV70012DCKT
U4: TLV70025_SC70; SC-70-5; MPN TLV70025DCKT
U5: TLV70033_SC70; SC-70-5; MPN TLV70033DCKR

Connections:
1V2_EN: R12.1, U3.3 (EN)
2V5_EN: R13.1, R14.1, U4.3 (EN), U5.3 (EN)
+1V2: C16.2, R14.2, U3.5 (VOUT)
+2V5: C18.2, U4.5 (VOUT)
+3V3: C21.2, R13.2, U5.5 (VOUT)
+5V: C17.2, C19.2, C20.2, R12.2, U3.1 (VIN), U4.1 (VIN), U5.1 (VIN)
GND: C16.1, C17.1, C18.1, C19.1, C20.1, C21.1, U3.2 (GND), U4.2 (GND), U5.2 (GND)

Notes on the sheet:
Power-up sequence: +5V => +1V2 => +3V3 => +2V5
