antmicro/programmable-led-panel/(commit log)

2025-01-27 [#72133] Add FPGA and Supply sheets
    [fpga.kicad_sch, led-panel.kicad_pcb, led-panel.kicad_sch, supply.kicad_sch]
2025-01-27 [#72133] Add rough schematic hierarchy
    [USB.kicad_sch, connector_triggers.kicad_sch, fpga.kicad_sch, led-panel.kicad_sch, matrix_drive.kicad_sch, supply.kicad_sch, uc_rp2040.kicad_sch]
2025-01-27 [#72133] Add USB mux
    [USB.kicad_sch, fpga.kicad_sch, led-panel.kicad_sch, uc_rp2040.kicad_sch]
2025-01-28 [#72133] Add protection to trigger conn
    [connector_triggers.kicad_sch]
2025-01-28 [#72133] Move executor switching to new scheet; Add FPGA flash programmer
    [USB.kicad_sch, control.kicad_sch, fpga.kicad_sch, supply.kicad_sch, uc_rp2040.kicad_sch]
2025-01-28 [#72133] Add LED matrix
    [led-panel.kicad_sch, matrix_drive.kicad_sch, matrix_high_side_drive.kicad_sch, matrix_low_side_drive.kicad_sch]
2025-01-28 [#72133] Unify sheet size
    [USB.kicad_sch, connector_triggers.kicad_sch, control.kicad_sch, fpga.kicad_sch, led-panel.kicad_sch, matrix_drive.kicad_sch, matrix_high_side_drive.kicad_sch, matrix_low_side_drive.kicad_sch]
2025-01-28 [#72133] Add capacitors on high side drive
    [matrix_high_side_drive.kicad_sch]
2025-01-29 [#72133] Add indicator LEDs & testpoints
    [USB.kicad_sch, connector_triggers.kicad_sch, control.kicad_sch, fpga.kicad_sch, matrix_drive.kicad_sch, matrix_high_side_drive.kicad_sch, supply.kicad_sch, uc_rp2040.kicad_sch]
2025-01-29 [#72133] Unify components
    [uc_rp2040.kicad_sch]
2025-01-29 [#72133] Coonect matrix control signals to uC/FPGA
    [fpga.kicad_sch, uc_rp2040.kicad_sch]
2025-01-29 [#72133] Annotate schematics
    [USB.kicad_sch, connector_triggers.kicad_sch, control.kicad_sch, fpga.kicad_sch, matrix_drive.kicad_sch, matrix_high_side_drive.kicad_sch, matrix_low_side_drive.kicad_sch, supply.kicad_sch]
2025-01-29 [#72133] Clean ERC
    [connector_triggers.kicad_sch]
2025-01-29 [#72133] Update symbol from lib
    [matrix_drive.kicad_sch]
2025-01-29 [#72133] Add mounting spacers
    [led-panel.kicad_sch]
2025-01-29 [#72133] Change connectors to horizontal
    [USB.kicad_sch, connector_triggers.kicad_sch, led-panel.kicad_sch]
2025-01-30 [#72133] Sch: Add IMU
    [IMU.kicad_sch, USB.kicad_sch, fpga.kicad_sch, led-panel.kicad_sch, uc_rp2040.kicad_sch]
2025-01-30 [#72133] Sch: Update power section
    [IMU.kicad_sch, supply.kicad_sch]
2025-01-30 [#72133] Sch: Update control hierarchy
    [USB.kicad_sch, connector_triggers.kicad_sch, control.kicad_sch, fpga.kicad_sch, led-panel.kicad_sch, matrix_high_side_drive.kicad_sch, supply.kicad_sch, uc_rp2040.kicad_sch]
2025-01-31 [#72133] Update supply schematic
    [IMU.kicad_sch, USB.kicad_sch, connector_triggers.kicad_sch, fpga.kicad_sch, led-panel.kicad_sch, matrix_drive.kicad_sch, matrix_high_side_drive.kicad_sch, matrix_low_side_drive.kicad_sch]
2025-01-31 [#72133] Update USB FTDI sheet
    [USB.kicad_sch, fpga.kicad_sch, led-panel.kicad_sch, supply.kicad_sch, uc_rp2040.kicad_sch]
2025-01-31 [#72133] Update USB sheets
    [USB-debug.kicad_sch, USB.kicad_sch, led-panel.kicad_sch]
2025-01-31 [#72133] Unify 12MHz generators
    [USB-debug.kicad_sch]
2025-01-31 [#72133] Add captions to schematic sheets
    [IMU.kicad_sch, USB.kicad_sch, connector_triggers.kicad_sch, led-panel.kicad_sch, matrix_drive.kicad_sch, matrix_high_side_drive.kicad_sch, matrix_low_side_drive.kicad_sch, uc_rp2040.kicad_sch]
2025-01-31 [#72133] Update trigger connectors sheet
    [connector_triggers.kicad_sch]
2025-01-31 [#72299] Place mounting holes & led modules; Set board edge
2025-01-31 [#72299] PCB: FPGA, Power & IMU placement done
2025-01-31 [#72299] PCB: Matrix drive placement/routing- WIP
2025-01-31 [#72299] PCB: Matrix drive placement
2025-01-31 [#72299] PCB: update FTDI placement
2025-02-03 [#72447] Change connectors to horizontal
    [USB-debug.kicad_sch, USB.kicad_sch, connector_triggers.kicad_sch]
2025-02-03 [#72447] Add more capcitors to FTDI
    [USB-debug.kicad_sch]
2025-02-03 [#72447] Unify capacitors
    [USB-debug.kicad_sch, fpga.kicad_sch]
2025-02-04 [#72447] Update clock & SPI connections
    [USB-debug.kicad_sch, fpga.kicad_sch, led-panel.kicad_sch, uc_rp2040.kicad_sch]
2025-02-04 [#72447] Add pulldown on IMU.FSYNC
    [IMU.kicad_sch]
2025-02-04 [#72447] SCH: remove unwanted junction
    [fpga.kicad_sch]
2025-02-04 [#72447] SCH: Update matrix drive resistors
    [IMU.kicad_sch, USB-debug.kicad_sch, USB.kicad_sch, connector_triggers.kicad_sch, fpga.kicad_sch, led-panel.kicad_sch, matrix_drive.kicad_sch, matrix_high_side_drive.kicad_sch]
2025-02-04 [#72447] Update designators
    [IMU.kicad_sch, USB-debug.kicad_sch, USB.kicad_sch, connector_triggers.kicad_sch, fpga.kicad_sch, led-panel.kicad_sch, matrix_drive.kicad_sch, matrix_high_side_drive.kicad_sch]
2025-02-04 [#72299] PCB: placement & HS routing finished
2025-02-04 [#72533] Correct LED panel position
2025-02-04 [#72533] PCB: routing- WIP
    [connector_triggers.kicad_sch]
2025-02-04 [#72533] PCB: routing complete
    [led-panel.kicad_sch, uc_rp2040.kicad_sch]
2025-02-04 [#72533] PCB: Finish layout
2025-02-05 [#72533] Fix malformed DNP components, fix DRC
    [IMU.kicad_sch, connector_triggers.kicad_sch, fpga.kicad_sch, led-panel.kicad_sch, uc_rp2040.kicad_sch]
2025-02-05 [#72533] Update USB track widths
2025-02-05 [#72533] Improve top GND plane
2025-08-06 Bump to KiCad 9.x
    [IMU.kicad_sch, USB-debug.kicad_sch, USB.kicad_sch, connector_triggers.kicad_sch, fpga.kicad_sch, led-panel.kicad_sch, matrix_drive.kicad_sch, matrix_high_side_drive.kicad_sch]
2025-08-06 Update PDF schematic
